gomb1ng/HexaButler-hexapode-stabilis-e-/github/images/hexabutler.jpeg

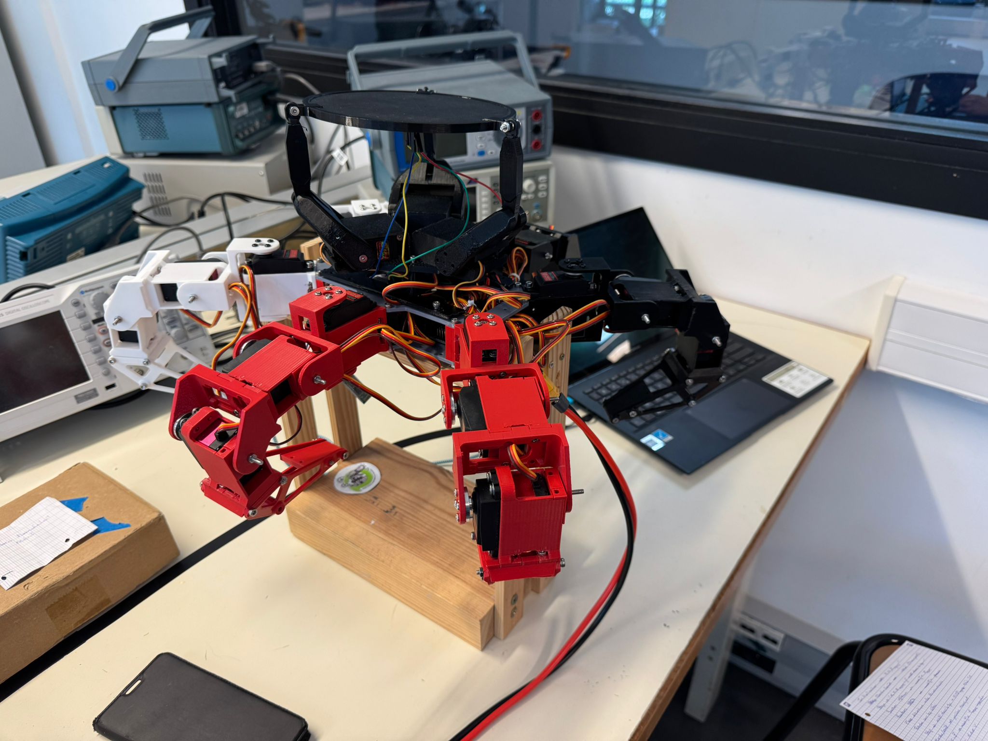
github/images/hexabutler.jpeg
