gomb1ng/HexaButler-hexapode-stabilis-e-/github/images/PlateformeV1(1).jpeg

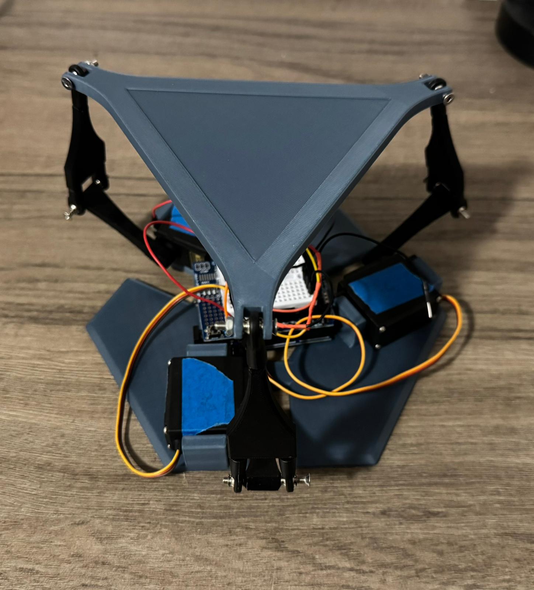
github/images/PlateformeV1(1).jpeg
