gomb1ng/HexaButler-hexapode-stabilis-e-/github/images/brasHexapod.jpeg

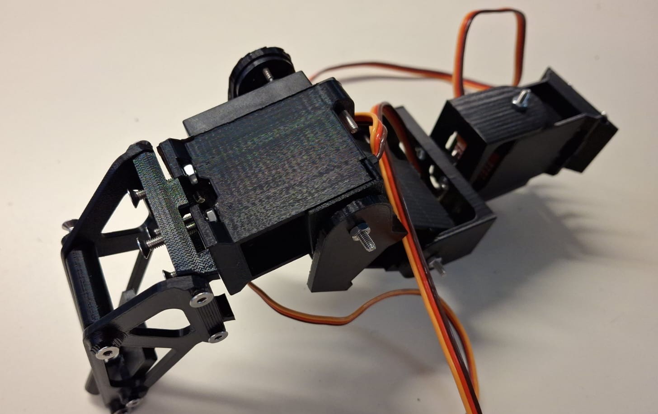
github/images/brasHexapod.jpeg
