gomb1ng/HexaButler-hexapode-stabilis-e-/github/images/composants de la plateforme.jpeg

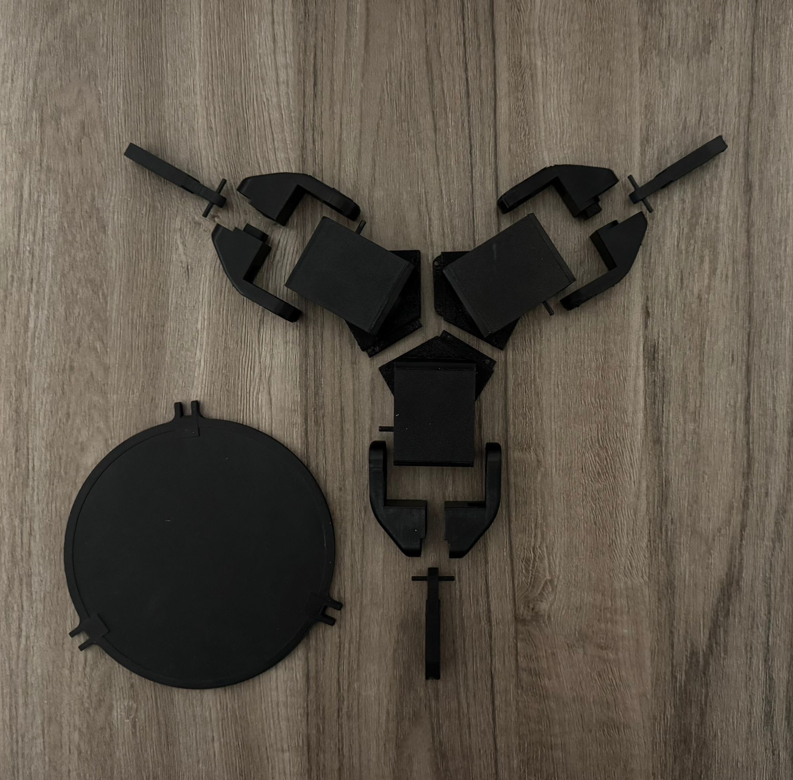
github/images/composants de la plateforme.jpeg
