gomb1ng/HexaButler-hexapode-stabilis-e-/github/images/hexabutler2.jpeg

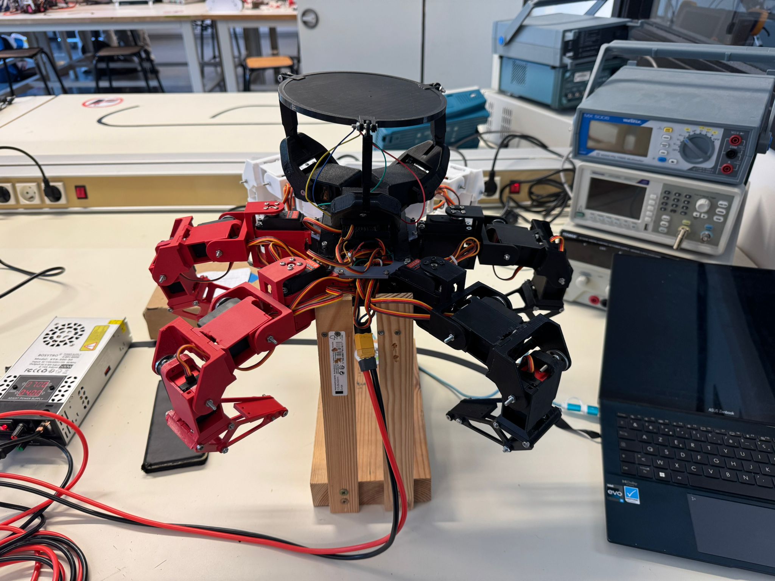
github/images/hexabutler2.jpeg
