gomb1ng/HexaButler-hexapode-stabilis-e-/github/images/PlateformeSatbilisée2.jpeg

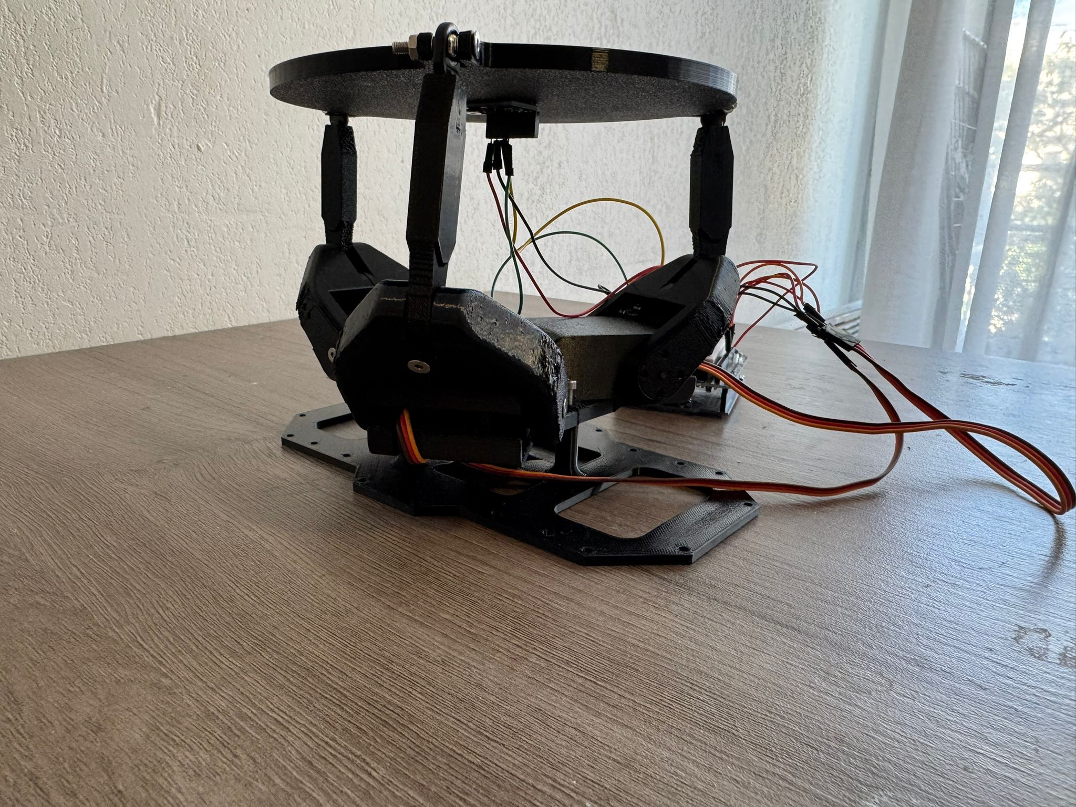
github/images/PlateformeSatbilisée2.jpeg
