gomb1ng/HexaButler-hexapode-stabilis-e-/github/images/plateformeStabilisée.jpeg

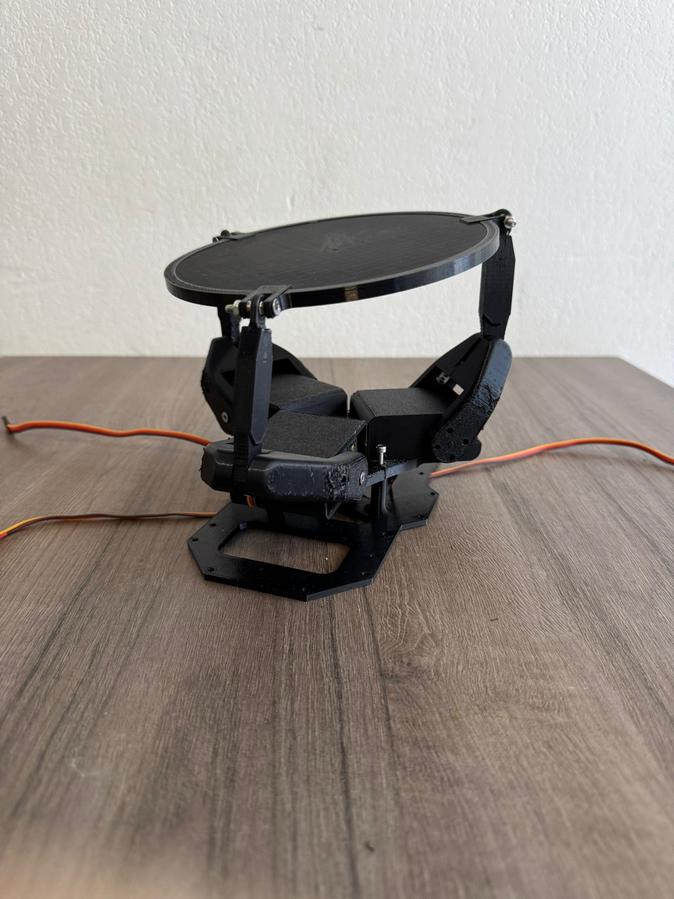
github/images/plateformeStabilisée.jpeg
