gomb1ng/HexaButler-hexapode-stabilis-e-/github/images/PlateformeV1(2).jpeg

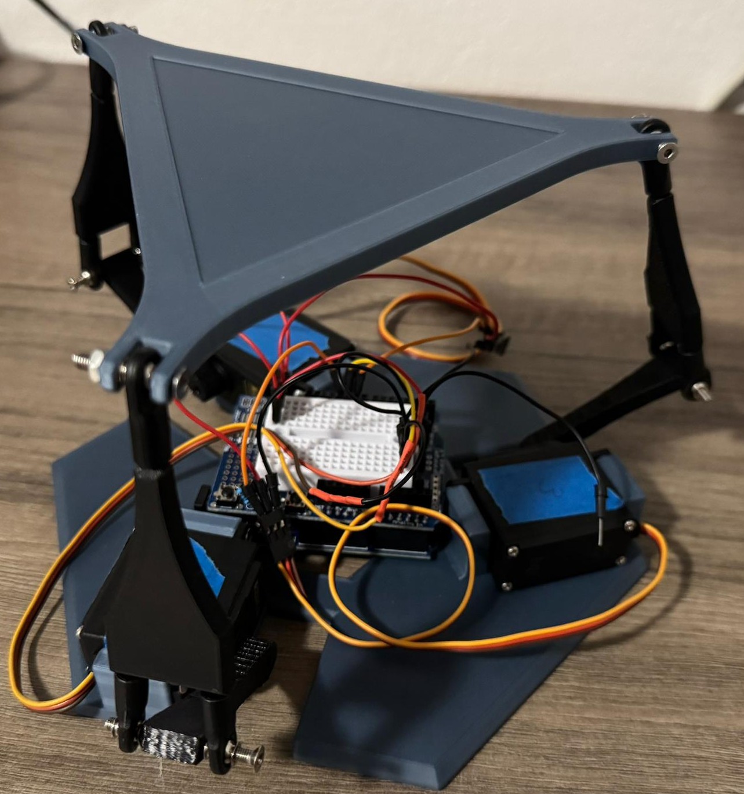
github/images/PlateformeV1(2).jpeg
