gomb1ng/HexaButler-hexapode-stabilis-e-/github/plateforme/Modele3DPlateforme/avantBrasV2.3mf

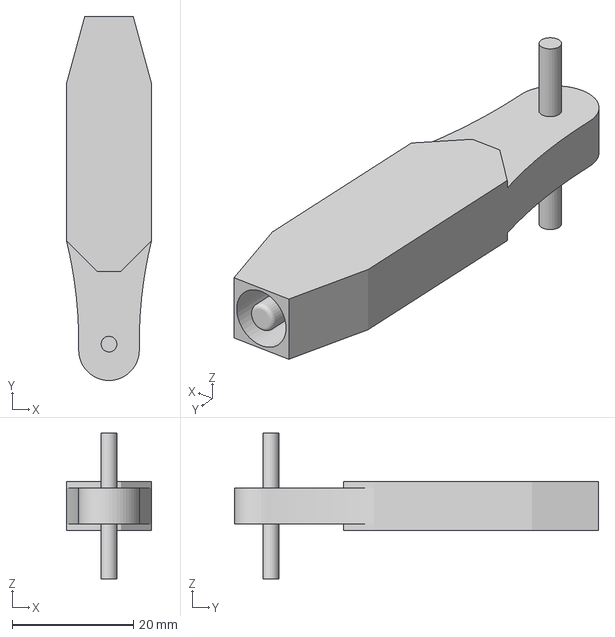
[picture p21: CAD file, 2026-05-26]
github/plateforme/Modele3DPlateforme/avantBrasV2.3mf
14.0 x 60.0 x 24.0 mm
