gomb1ng/HexaButler-hexapode-stabilis-e-/github/plateforme/Modele3DPlateforme/brasGaucheV2.3mf

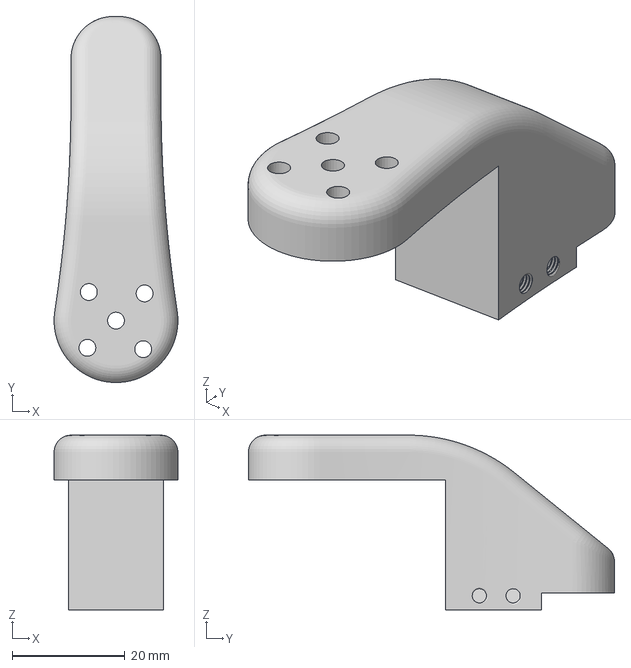
[picture p22: CAD file, 2026-05-26]
github/plateforme/Modele3DPlateforme/brasGaucheV2.3mf
22.0 x 65.0 x 31.0 mm
