gomb1ng/HexaButler-hexapode-stabilis-e-/github/plateforme/Modele3DPlateforme/baseHexapodSupportMotorV2.3mf

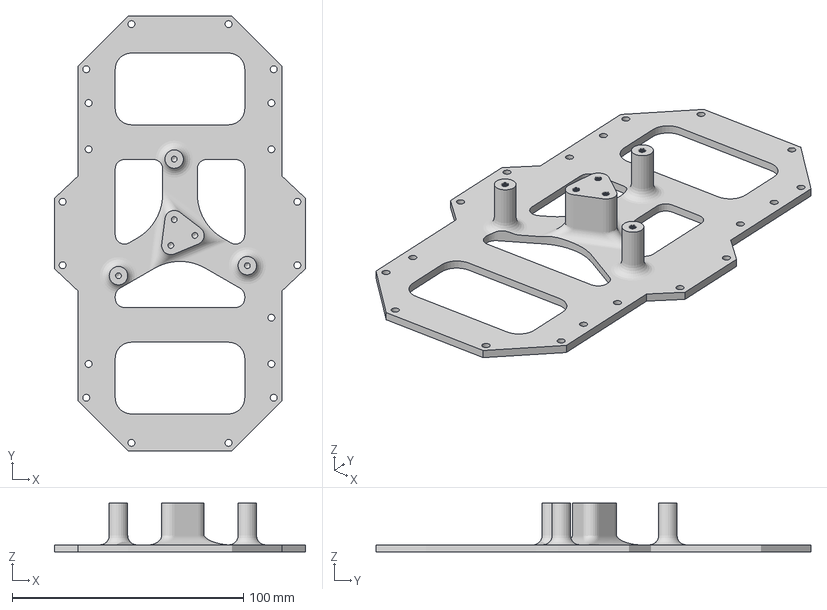
[picture p23: CAD file, 2026-05-26]
github/plateforme/Modele3DPlateforme/baseHexapodSupportMotorV2.3mf
108.5 x 188.0 x 21.0 mm
