gomb1ng/HexaButler-hexapode-stabilis-e-/github/plateforme/Modele3DPlateforme/brasDroitV2.3mf

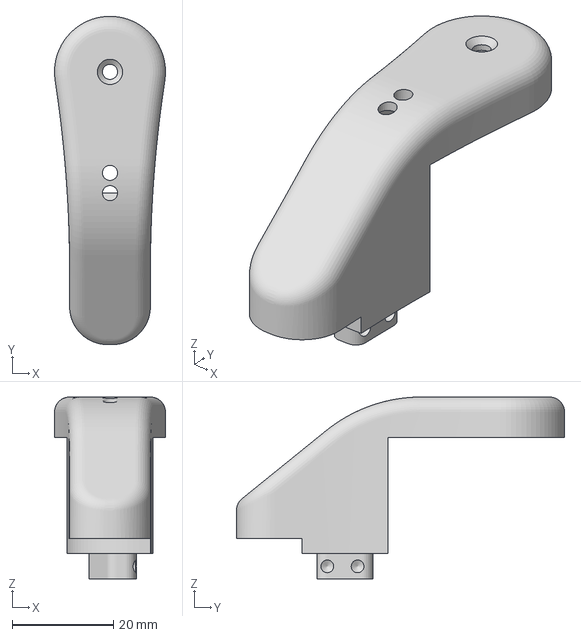
[picture p24: CAD file, 2026-05-26]
github/plateforme/Modele3DPlateforme/brasDroitV2.3mf
22.0 x 65.0 x 36.0 mm
