gomb1ng/HexaButler-hexapode-stabilis-e-/github/plateforme/Modele3DPlateforme/plateauV2.3mf

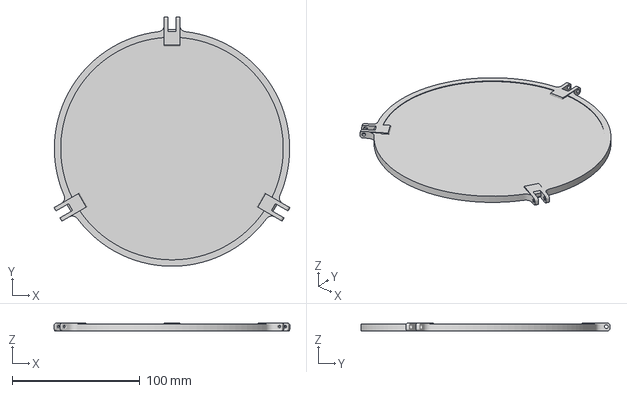
[picture p25: CAD file, 2026-05-26]
github/plateforme/Modele3DPlateforme/plateauV2.3mf
184.5 x 195.0 x 6.00 mm
