gomb1ng/HexaButler-hexapode-stabilis-e-/github/plateforme/Modele3DPlateforme/supportMotorV2.3mf

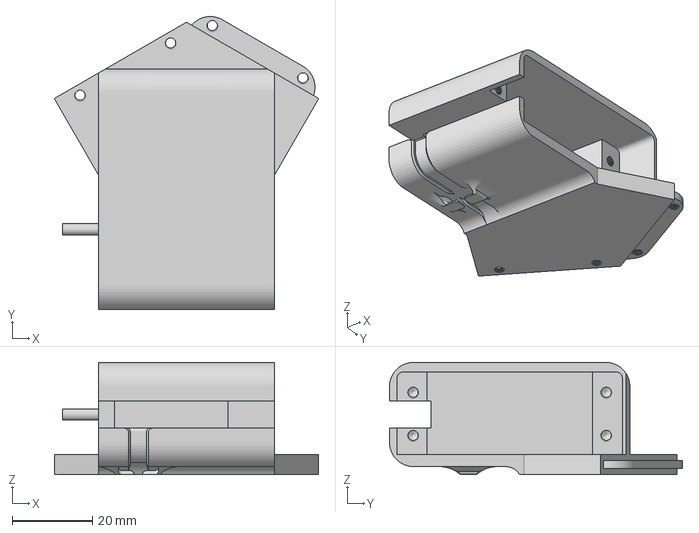
[picture p26: CAD file, 2026-05-26]
github/plateforme/Modele3DPlateforme/supportMotorV2.3mf
66.0 x 73.1 x 28.0 mm
